KiranPranay/predictive_bms/docs/README.md

# Documents

| File | What it is |
| --- | --- |
| [build-guide/Build-Guide.pdf](build-guide/Build-Guide.pdf) | The build guide in one PDF: single-line diagram, circuit diagrams, ESP32 pin map, components and costs, wiring between the units, both perfboards hole by hole with placement tables and wiring lists, assembly steps, checks before power, bring-up, snapshots of the simulation, and the circuit simulation in KiCad and the model check in GNU Octave |
| [wiring.md](wiring.md) | How to build the prototype from modules on perfboard, without a PCB: every connection, every part value, the board layout |
| [firmware.md](firmware.md) | How the firmware and the supervisor core work, how each part maps to the architecture, the console commands, the telemetry formats, and every value the architecture does not set |
| [bring-up.md](bring-up.md) | What to do with the firmware and the tools at each build gate, 0 to 12 |
| [simulator.md](simulator.md) | The simulated pack, the 30 test scenarios, the guided demonstrations, and what they found |
| [gate-records.md](gate-records.md) | Record sheets to fill in and sign at each gate |
| [architecture/](architecture/) | The project's technical documents, copied from the bms-moosi repository |

## The architecture documents

The files in [architecture/](architecture/) are copies of the bms-moosi repository's `docs/`
folder at commit `0efe68e` (27 October 2026):

- `current-architecture.md` and `.svg`: revision 2.2, the build authority. Every engineering
  value in the firmware comes from it.
- `safe-build-sequence.md`: Gates 0 to 12 with their pass and stop criteria.
- `bom.csv` and `costing.csv`: the parts and their costs.

## The build guide

`build-guide/build_guide.py` makes the figures (`figures.py`), the HTML and the PDF. Section 16
takes its results from `../kicad/run_sims.py` (`build-guide/kicad-sim/` and the `sim-*` and
`kicad-*` figures) and from the Octave scripts in `../matlab/` (`build-guide/matlab/`). The two
perfboards are described once, in `build-guide/boards.py`, and checked for shorts and open nets
before anything is drawn. `build-guide/snapshots.py` runs the guided demonstrations in a browser
and saves the pictures of the simulation (it needs Playwright).

```bash
python3 docs/build-guide/build_guide.py
```

## Editing the architecture copies

Do not edit the copies here. The bms-moosi repository holds the original: change it there
first, copy the files again, then update `firmware/components/bms_core/include/bms/config.h`
and run all the tests.
