KiranPranay/predictive_bms/docs/presentation/images/board_a_top.png

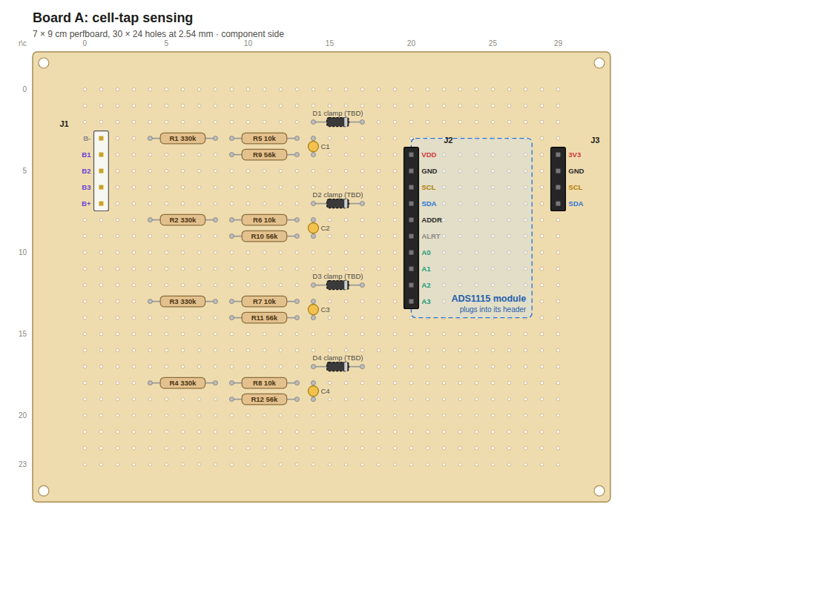
docs/presentation/images/board_a_top.png
