KiranPranay/predictive_bms/docs/presentation/images/board_b_top.png

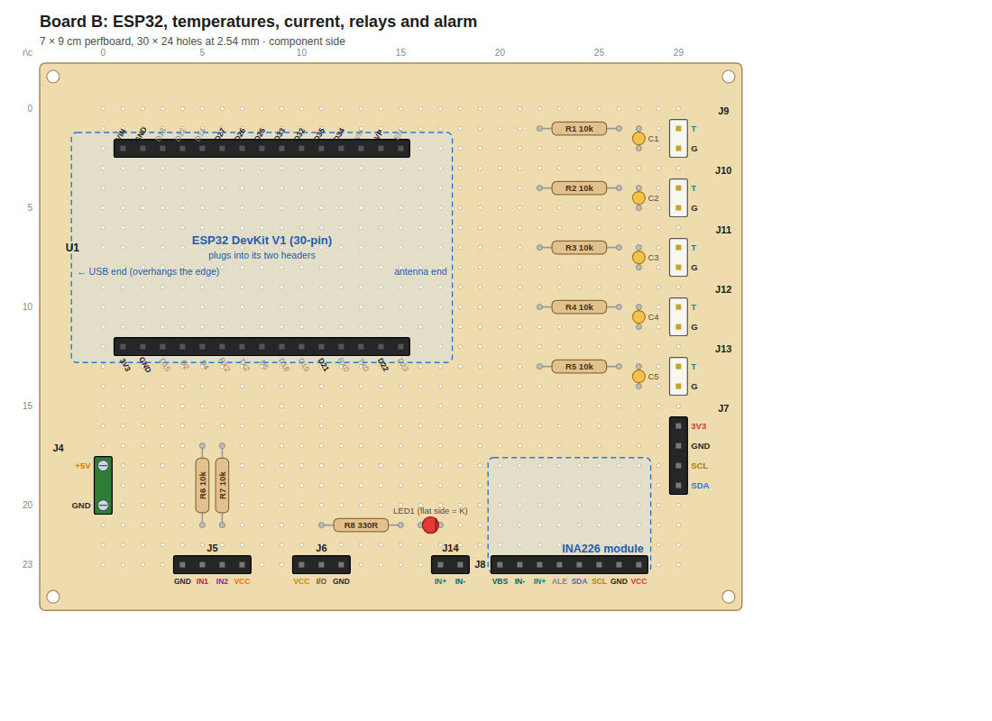
docs/presentation/images/board_b_top.png
