KiranPranay/predictive_bms/docs/presentation/images/circuit_control.png

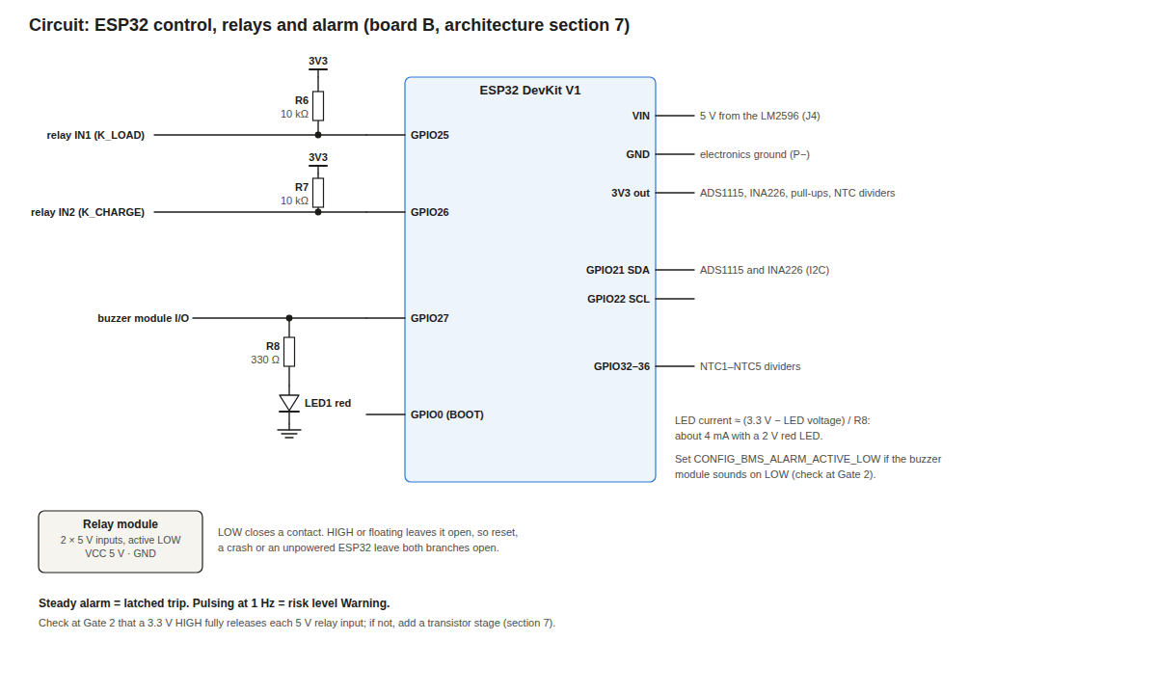
docs/presentation/images/circuit_control.png
