KiranPranay/predictive_bms/docs/presentation/images/crosscheck_heat_no_current.png

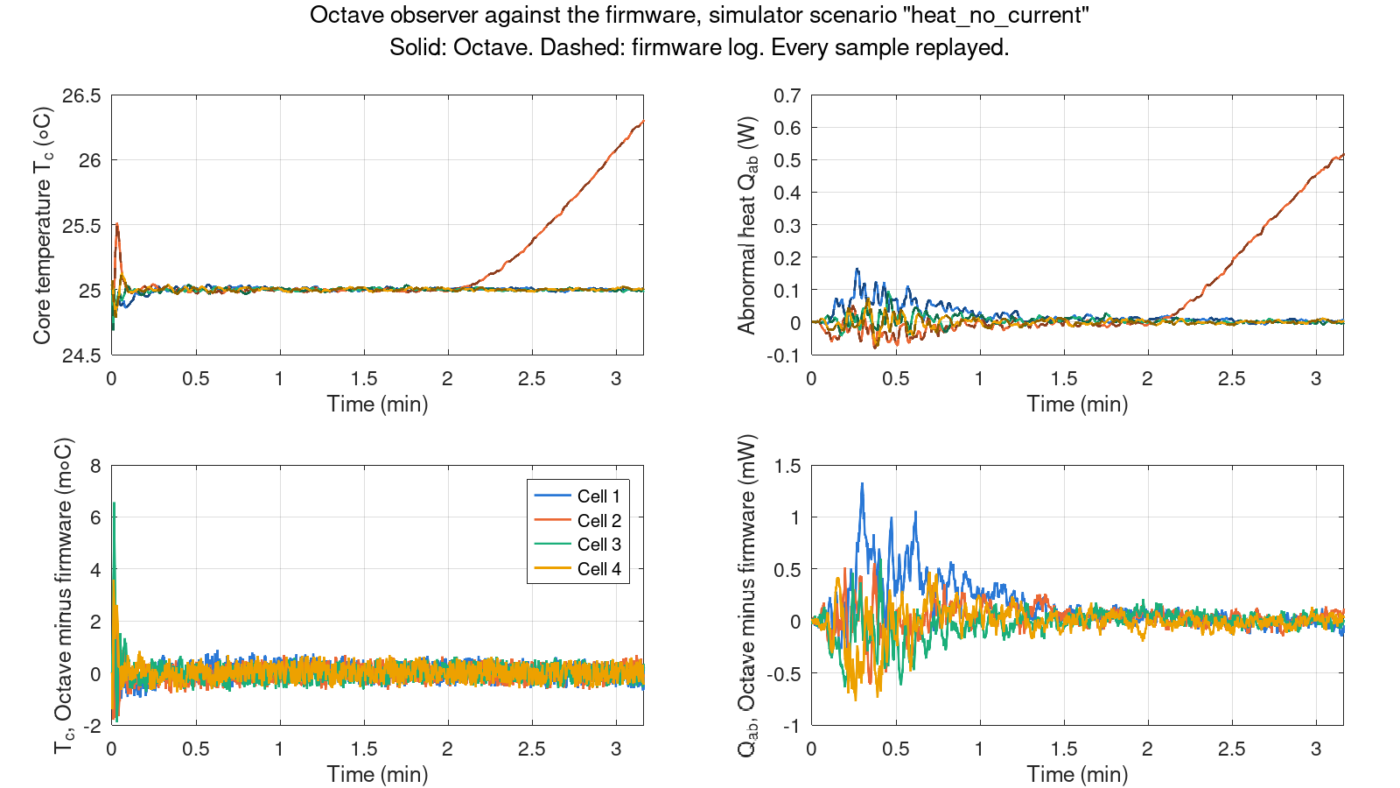
docs/presentation/images/crosscheck_heat_no_current.png
