KiranPranay/predictive_bms/docs/presentation/images/kicad_cell_taps.png

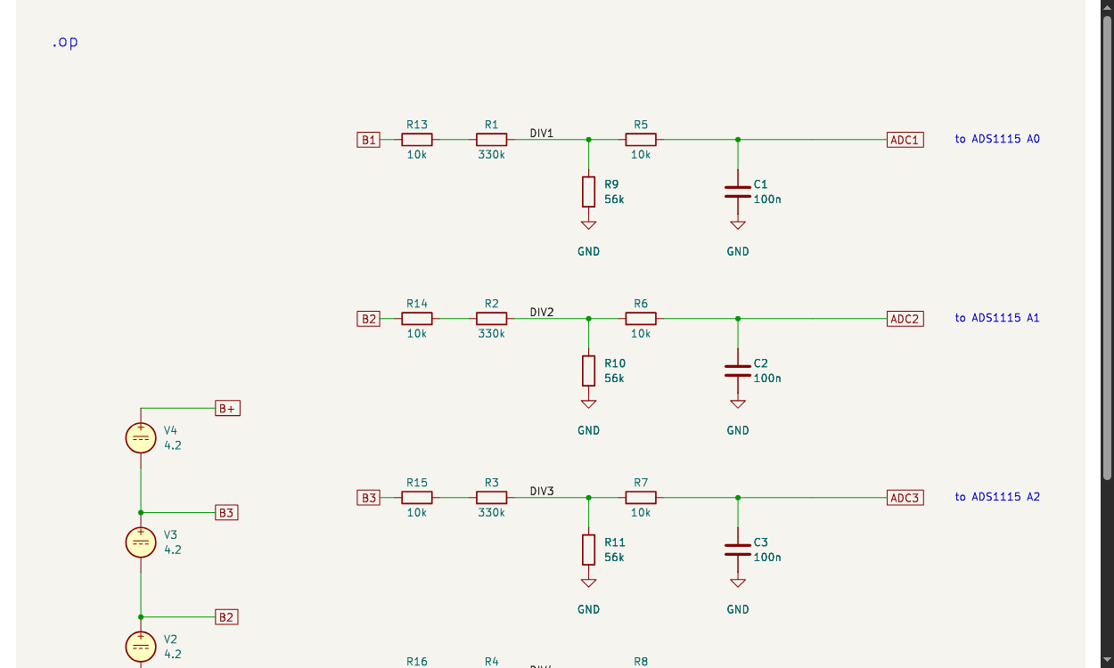
docs/presentation/images/kicad_cell_taps.png
