KiranPranay/predictive_bms/docs/presentation/images/sld.png

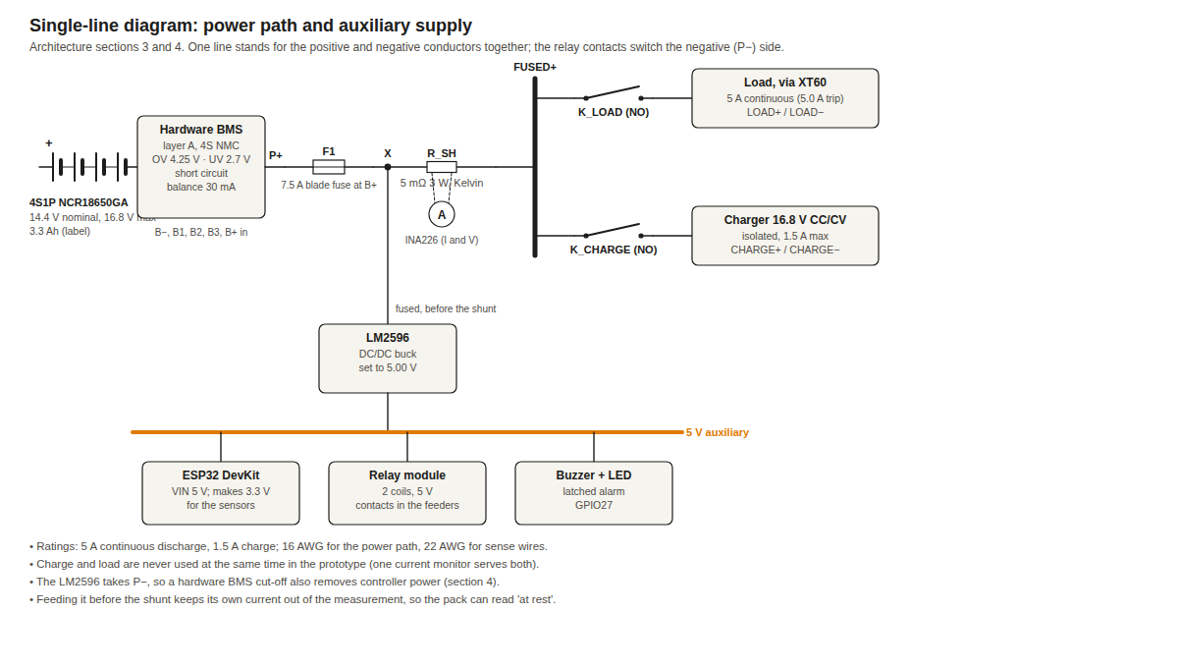
docs/presentation/images/sld.png
