KiranPranay/predictive_bms/docs/presentation/images/xcos_abnormal_heat.png

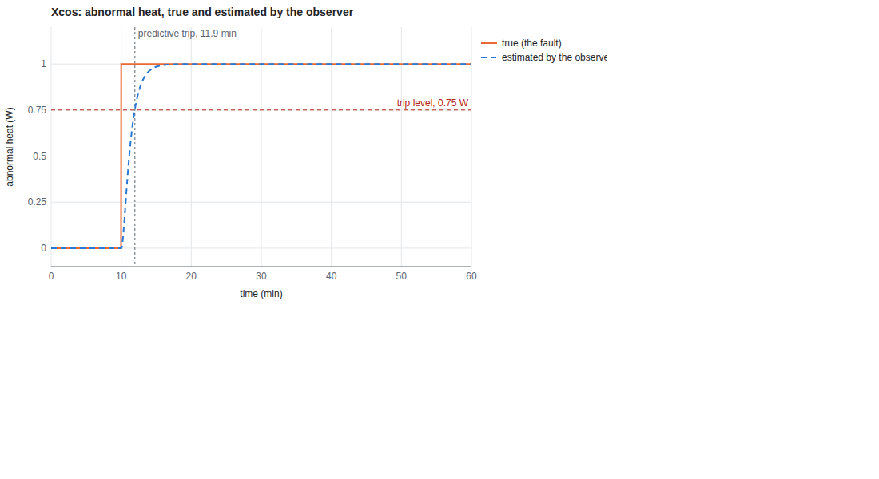
docs/presentation/images/xcos_abnormal_heat.png
