KiranPranay/predictive_bms/docs/presentation/images/xcos_temperatures.png

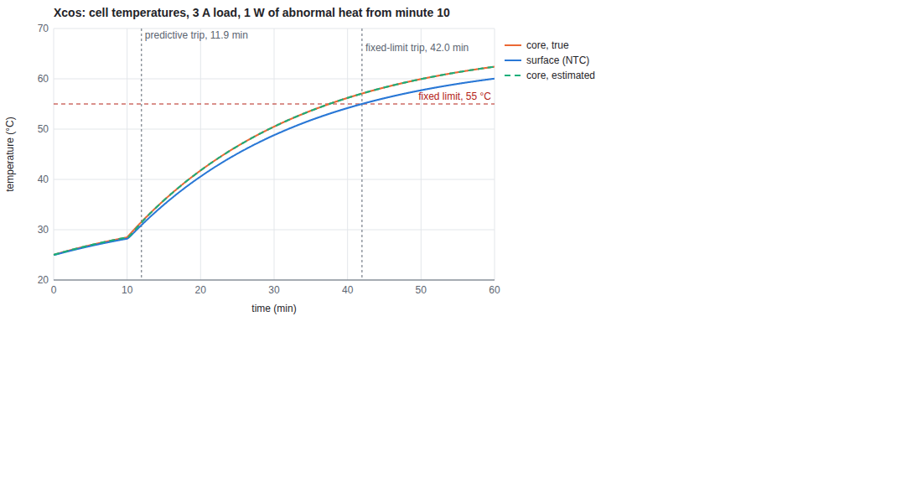
docs/presentation/images/xcos_temperatures.png
