KiranPranay/predictive_bms/docs/presentation/images/wiring_overview.png

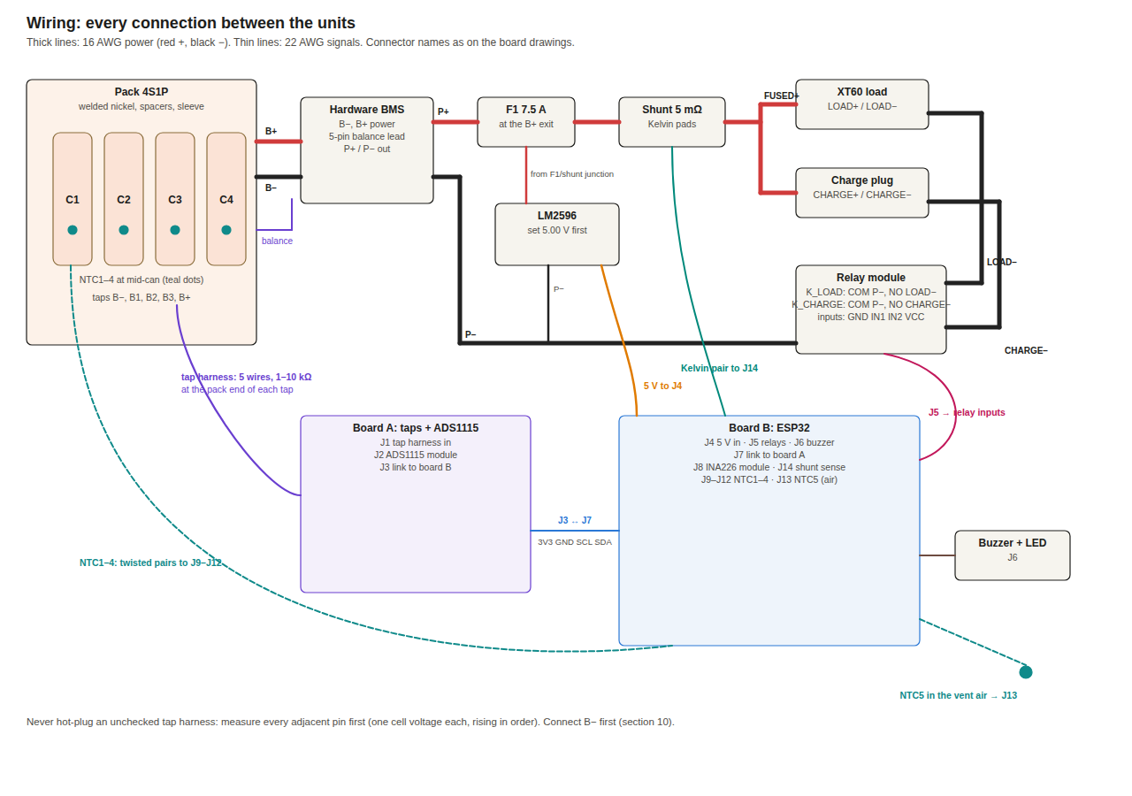
docs/presentation/images/wiring_overview.png
