KiranPranay/predictive_bms/kicad/sim/cell-taps/cell-taps.kicad_sch

## KiCad design kicad/sim/cell-taps/cell-taps.kicad_sch (2026-10-30)

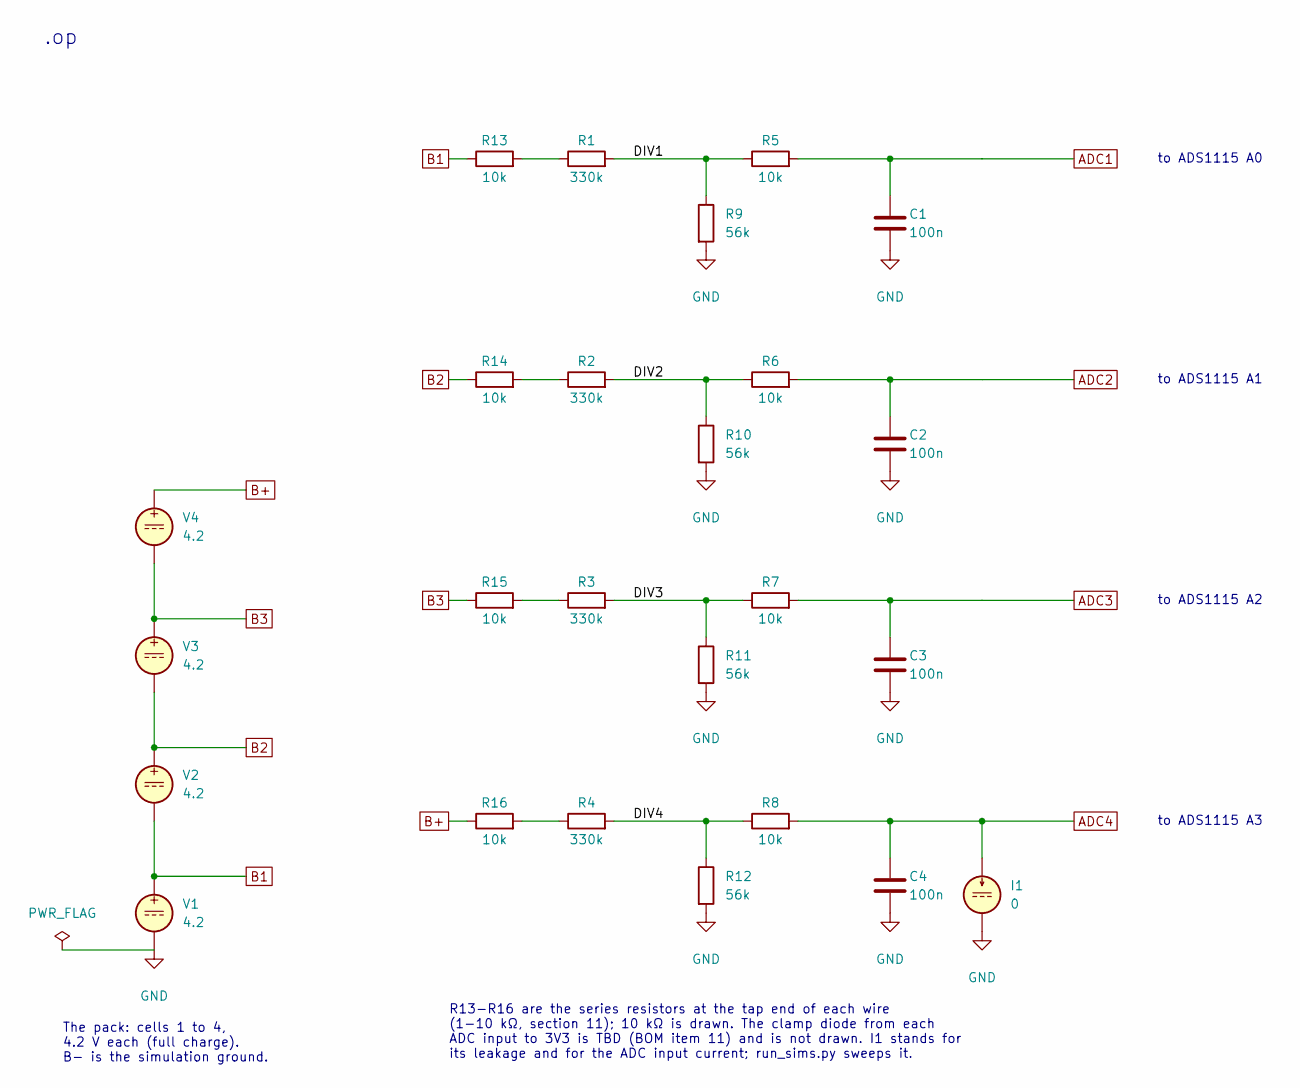
[picture p28: schematic cell-taps.kicad_sch]

Parts:
C1, C2, C3, C4: 100n
I1: 0
R1, R2, R3, R4: 330k
R5, R6, R7, R8, R13, R14, R15, R16: 10k
R9, R10, R11, R12: 56k
V1, V2, V3, V4: 4.2

Connections:
ADC1: C1.1, R5.2
ADC2: C2.1, R6.2
ADC3: C3.1, R7.2
ADC4: C4.1, I1.1, R8.2
B1: R13.1, V1.1, V2.2
B2: R14.1, V2.1, V3.2
B3: R15.1, V3.1, V4.2
B+: R16.1, V4.1
DIV1: R1.2, R5.1, R9.1
DIV2: R2.2, R6.1, R10.1
DIV3: R3.2, R7.1, R11.1
DIV4: R4.2, R8.1, R12.1
GND: C1.2, C2.2, C3.2, C4.2, I1.2, R9.2, R10.2, R11.2, R12.2, V1.2
unnamed: R1.1, R13.2
unnamed: R2.1, R14.2
unnamed: R3.1, R15.2
unnamed: R4.1, R16.2

Notes on the sheet:
The pack: cells 1 to 4, 4.2 V each (full charge). B- is the simulation ground.
to ADS1115 A0
to ADS1115 A1
to ADS1115 A2
to ADS1115 A3
.op
R13-R16 are the series resistors at the tap end of each wire (1-10 kΩ, section 11); 10 kΩ is drawn. The clamp diode from each ADC input to 3V3 is TBD (BOM item 11) and is not drawn. I1 stands for its leakage and for the ADC input current; run_sims.py sweeps it.
