KiranPranay/predictive_bms/kicad/sim/current-sense/current-sense.kicad_sch

## KiCad design kicad/sim/current-sense/current-sense.kicad_sch (2026-10-30)

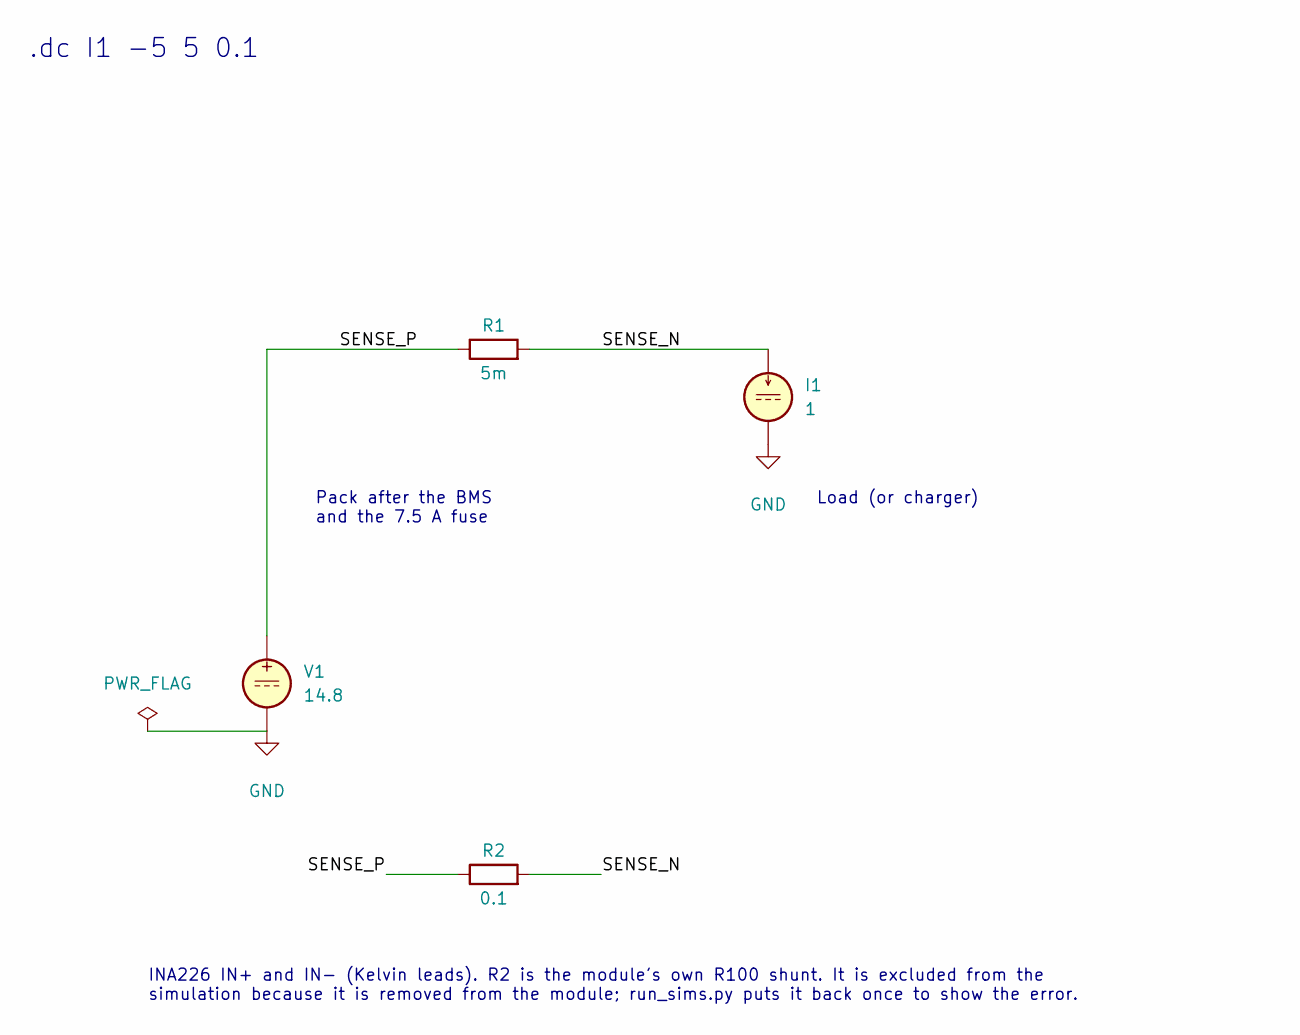
[picture p29: schematic current-sense.kicad_sch]

Parts:
I1: 1
R1: 5m
R2: 0.1
V1: 14.8

Connections:
GND: I1.2, V1.2
SENSE_N: I1.1, R1.2, R2.2
SENSE_P: R1.1, R2.1, V1.1

Notes on the sheet:
Pack after the BMS and the 7.5 A fuse
Load (or charger)
INA226 IN+ and IN- (Kelvin leads). R2 is the module's own R100 shunt. It is excluded from the simulation because it is removed from the module; run_sims.py puts it back once to show the error.
.dc I1 -5 5 0.1
