KiranPranay/predictive_bms/kicad/sim/ntc-divider/ntc-divider.kicad_sch

## KiCad design kicad/sim/ntc-divider/ntc-divider.kicad_sch (2026-10-30)

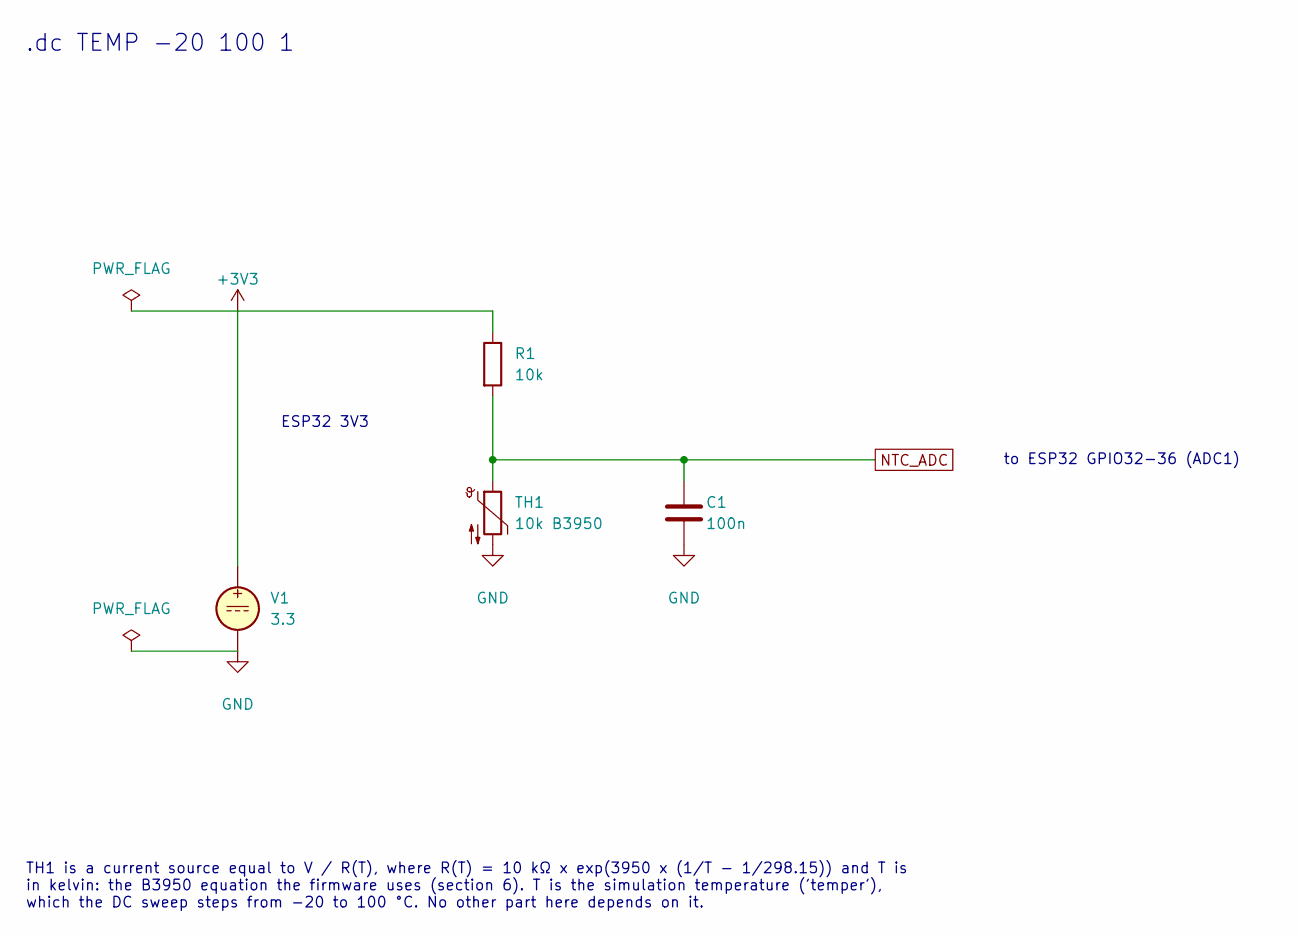
[picture p30: schematic ntc-divider.kicad_sch]

Parts:
C1: 100n
R1: 10k
TH1: 10k B3950
V1: 3.3

Connections:
+3V3: R1.1, V1.1
GND: C1.2, TH1.2, V1.2
NTC_ADC: C1.1, R1.2, TH1.1

Notes on the sheet:
ESP32 3V3
to ESP32 GPIO32-36 (ADC1)
.dc TEMP -20 100 1
TH1 is a current source equal to V / R(T), where R(T) = 10 kΩ x exp(3950 x (1/T - 1/298.15)) and T is in kelvin: the B3950 equation the firmware uses (section 6). T is the simulation temperature ('temper'), which the DC sweep steps from -20 to 100 °C. No other part here depends on it.
