KiranPranay/predictive_bms/kicad/sim/thermal-model/thermal-model.kicad_sch

## KiCad design kicad/sim/thermal-model/thermal-model.kicad_sch (2026-10-30)

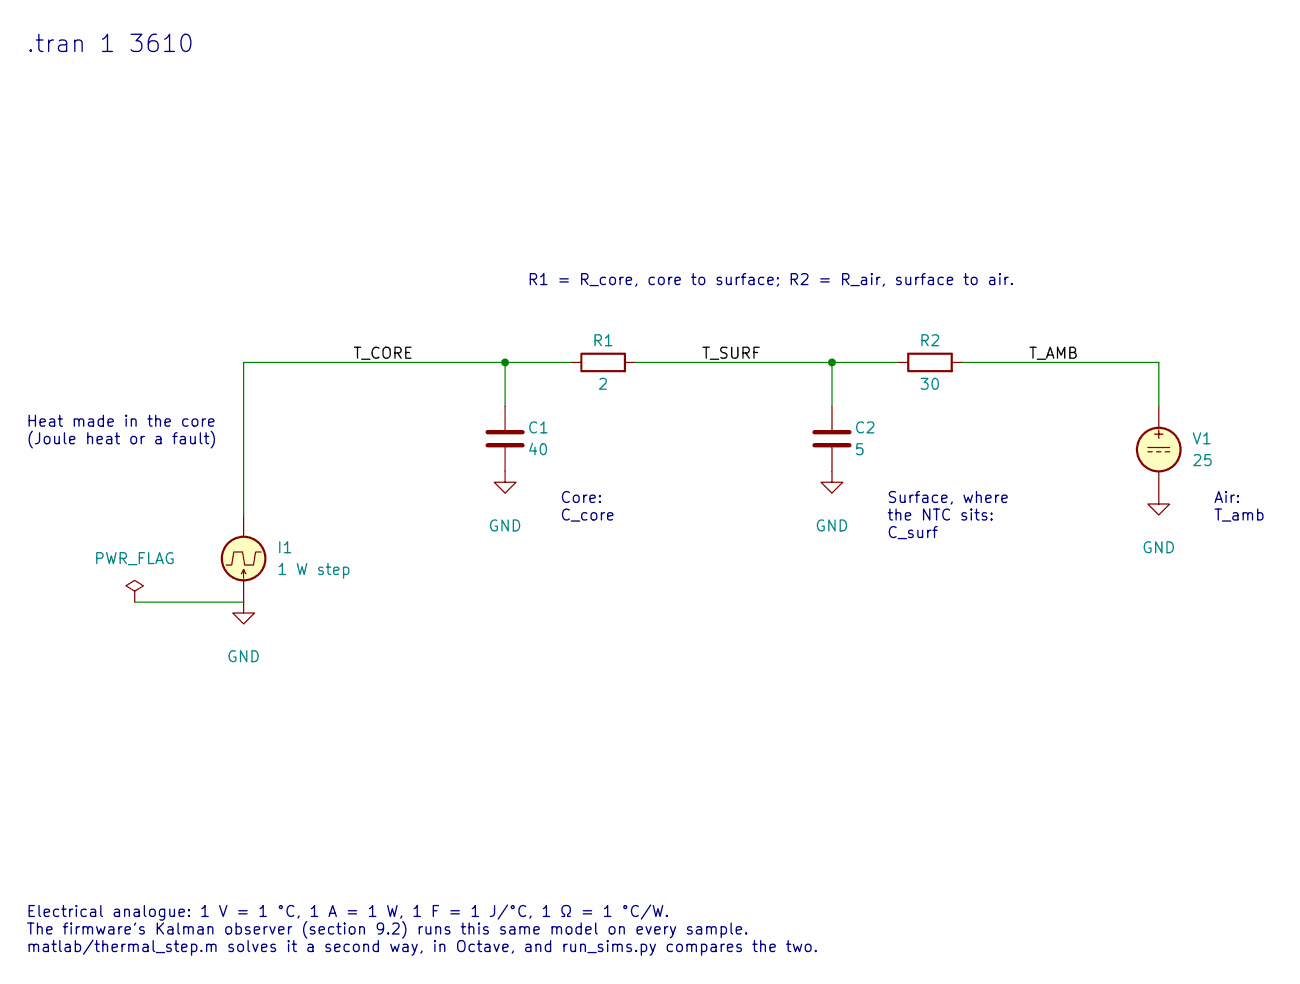
[picture p31: schematic thermal-model.kicad_sch]

Parts:
C1: 40
C2: 5
I1: 1 W step
R1: 2
R2: 30
V1: 25

Connections:
GND: C1.2, C2.2, I1.1, V1.2
T_AMB: R2.2, V1.1
T_CORE: C1.1, I1.2, R1.1
T_SURF: C2.1, R1.2, R2.1

Notes on the sheet:
Heat made in the core (Joule heat or a fault)
Core: C_core
Surface, where the NTC sits: C_surf
Air: T_amb
R1 = R_core, core to surface; R2 = R_air, surface to air.
Electrical analogue: 1 V = 1 °C, 1 A = 1 W, 1 F = 1 J/°C, 1 Ω = 1 °C/W. The firmware's Kalman observer (section 9.2) runs this same model on every sample. matlab/thermal_step.m solves it a second way, in Octave, and run_sims.py compares the two.
.tran 1 3610
