KiranPranay/predictive_bms/(commit log)

2026-10-29 Prototype: supervisor firmware, simulated pack, dashboard and bench tools
    Builds the predictive thermal BMS of architecture revision 2.2 (bms-moosi) without a PCB:
    modules on perfboard, supervised by an ESP32.
    - bms_core: every algorithm of sections 5-10 in portable C++ (filters, limits and latches,
    two-state thermal model, Kalman observer, predict and confirm, online resistance, rest leak
    estimate and cross-check, forecasts, risk levels).
    - ESP-IDF v5.5 firmware: ADS1115, INA226 and NTC drivers, relays that start open, 5 Hz safety
    task with watchdog, latch kept in flash, console, Wi-Fi dashboard; bench build for Gates 2-3.
    - Simulated pack, 26 unit tests and 29 scenarios rehearsing G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
2026-10-29 Simulation demos for the GUI and the illustrated build guide
    - Dashboard on the simulator: nine guided demonstrations with narration, a fixed-limit BMS
    copy of the pack running alongside for comparison, a live system diagram, a forecast
    against reading chart, and the verification results of every scenario.
    - Simulator: fresh, pause and resume commands; a run counter; a cell defect that heats under
    load; per-cell state of charge; JSON report of every scenario. New scenario load_defect (30).
    - tools/demo.py builds the simulator if needed and opens the dashboard.
    - Build guide (docs/build-guide/Build-Guide.pdf): single-line diagram, circuit diagrams,
    firmware data flow and risk levels,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
2026-10-30 Circuit simulation in KiCad and the model check in GNU Octave
    kicad/: the cell taps, an NTC divider, the current shunt and the cell's
    thermal model as KiCad 10 sheets, simulated with ngspice. run_sims.py
    exports them with kicad-cli, runs ngspice and checks the results against
    the architecture; KiCad's ERC finds no violation.
    matlab/: the thermal model and the Kalman observer in GNU Octave, also
    runnable in MATLAB. crosscheck.m compares them with the firmware on the
    simulator's per-sample logs (new: bms_sim run --csv-all).
    Build guide section 16 shows the sheets, the charts and the checks.
2026-10-30 Windows package: ready-to-run demo, KiCad, Octave and Xcos files, tested on Windows
    tools/package_windows.py makes one folder and zip with the demo (an embedded Python and bms_sim.exe, started by a .bat file), the KiCad projects, the Octave scripts and the documents. The demo and the Octave scripts find their files in the package as well as in the repository; the demo moves to the next port when 8080 is taken; the Octave figures open on the screen when the scripts run in the Octave window.
    .github/workflows/windows.yml builds it with MSVC and tests it on Windows: the demo from its .bat file, the Octave scripts in GNU Octave, the KiCad projects with KiCad's own ngspice, and Scilab with Xcos.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
2026-10-30 Windows package: crosscheck runs the simulator from Octave for Windows; Scilab 2027.0.0 check
    Octave for Windows adds its own outer quotes to a system() command, so crosscheck adds them only in MATLAB; with both, a folder name with spaces broke the command. The demo prints its address at once. The Windows test checks that Scilab 2027.0.0, the version the Xcos models are made with, writes, reads and simulates an Xcos diagram.
2026-10-30 Windows test: report what the Octave window does; find KiCad's default library table
2026-10-30 Windows test: start the Octave window with its launcher; install KiCad to a known folder
2026-10-30 Windows test: wait for the KiCad installer; give the Octave window its Qt plugins
2026-10-30 Xcos models in Scilab: the cell's thermal model and abnormal heat detection
    cell_thermal_model.zcos is the two-node model of section 9.1; it agrees with
    ngspice and Octave within 0.004 degC. abnormal_heat_detection.zcos adds the
    section 9.2 observer (the gain the firmware's Kalman filter settles to): the
    predictive trip comes 117 s after a 1 W fault, the fixed 55 degC limit 32
    minutes later. check_models.sce simulates and checks both without a window.
2026-10-30 Windows test: unpack KiCad with 7-Zip instead of its silent installer
2026-10-31 firmware: ACS712 current fallback; docs: Review 2 deck and build guide updates
    Add ACS712 analog current sensor fallback on ADC1 GPIO39 when INA226 is absent. Add disconnected banner in dashboard. Include Major Project Stage 1 Review 2 presentation deck generator, slides, and build guide pin tables.
